bbsmith24/YamuraHubV6.1/README.md

## YamuraLog Hub
Control for YamuraLog sensor network. Start/Stop logging, save log file to microSD, handle FTP communications with data viewer

## Hardware
- Teensy 4.1. Log files go to its built-in microSD slot (4-bit SDIO, `SD.begin(BUILTIN_SDCARD)`), not the display's SD slot.
- Waveshare SN65HVD230 CAN tranciever
- Hosyond 4" 320x480 display (with built in microSD card slot)
- Adafruit Airlift

## Required Libraries
This is a Visual Code/Platform IO project, I don't recommend using Arduino IDE for this, although the code did start there.
Install these libraries:

- `WiFiNINA - Adafruit fork`
- `SPI`
- 'TFT_eSPI'
- 'FlexCan_T4'
- 'ArduinoJson'

## Usage

1. Open `WiFiSecrets.h`.
2. Replace the WiFi credentials:
   - `YOUR_SSID`
   - `YOUR_WIFI_PASSWORD`
3. Replace the FTP server details:
   - `FTP_SERVER`
   - `FTP_USER`
   - `FTP_PASS`
   - 'FTP_PATH'
4. Adjust pin definitions in main.h as needed:
5. Build and upload to Teensy 4.1.
6. For full debug messages, uncomment #define DEBUG_EXTRA_VERBOSE. Use #define DEBUG_VERBOSE for more serious(?) messages
7. Open Serial Monitor at `115200` baud.

## Configuration (SD `config.ini`)

The values in `WiFiSecrets.h` are compiled-in **defaults**. If a `config.ini`
file is present at the top level of the SD card, its fields override those
defaults at boot, and its `[drivers]` section fills the Select Driver menu.
Copy `config.ini.sample` to the card as `config.ini` and edit it. Any field you
omit keeps its compiled default. This keeps real credentials off committed
source. See `Config.h` for the format.

## Notes

- To log anything, you need at least 1 YamuraLog node (GPS, IMU, A/D), appropriate CAN cables and terminators.

## PlatformIO

A `platformio.ini` file is included for Teensy 4.1 builds (`env:teensy41`).
