bbsmith24/YamuraHubV6.1/hardware/YamuraHub_T41/docs/YamuraHub_T41_top.png

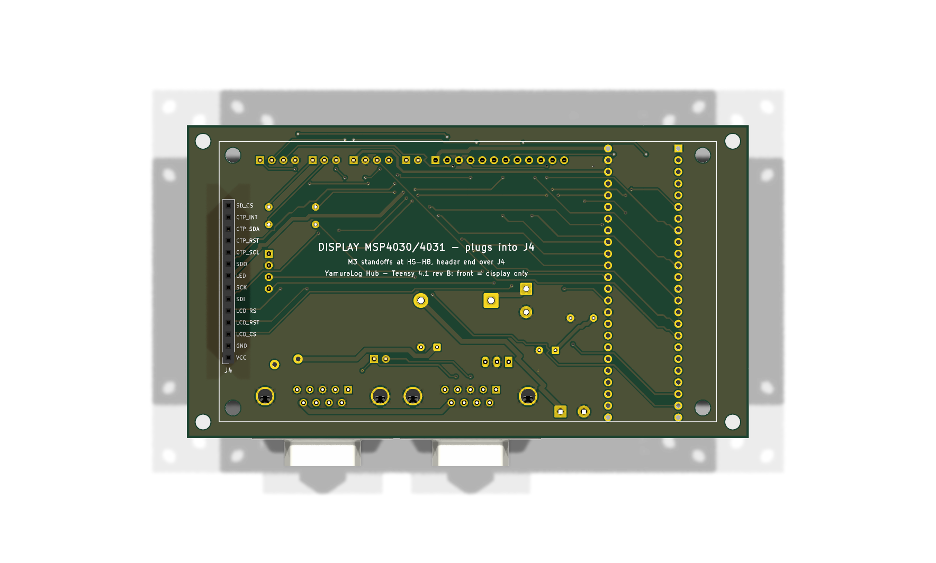
hardware/YamuraHub_T41/docs/YamuraHub_T41_top.png
