bbsmith24/YamuraHubV6.1/hardware/YamuraHub_T41/fab/YamuraHub_T41_BOM.csv

Reference | Value | Footprint | QUANTITY
A1 | Teensy 4.1 | YamuraHub:Teensy41 | 1
A2 | Adafruit AirLift (ESP32) | Connector_PinSocket_2.54mm:PinSocket_1x12_P2.54mm_Vertical | 1
A3 | Waveshare SN65HVD230 CAN board | Connector_PinSocket_2.54mm:PinSocket_1x04_P2.54mm_Vertical | 1
C1 | 47uF 35V | Capacitor_THT:CP_Radial_D8.0mm_P3.50mm | 1
C2 | 47uF 16V | Capacitor_THT:CP_Radial_D8.0mm_P3.50mm | 1
C3 | 100nF | Capacitor_THT:C_Disc_D5.0mm_W2.5mm_P5.00mm | 1
D1 | 1N5822 | Diode_THT:D_DO-201AD_P15.24mm_Horizontal | 1
D4 | 1.5KE20A (TVS) | Diode_THT:D_DO-201AE_P5.08mm_Vertical_CathodeUp | 1
F1 | MF-RG110 (1.1A PTC) | Fuse:Fuse_Bourns_MF-RG1100 | 1
J1 | 12V in | TerminalBlock_Phoenix:TerminalBlock_Phoenix_MKDS-1,5-2-5.08_1x02_P5.08mm_Horizontal | 1
J2 | CAN H/L (from A3) | Connector_PinHeader_2.54mm:PinHeader_1x02_P2.54mm_Vertical | 1
J3 | DB9 male - CAN bus 1 | Connector_Dsub:DSUB-9_Pins_Horizontal_P2.77x2.84mm_EdgePinOffset7.70mm_Housed_MountingHolesOffset9.12mm | 1
J4 | Display socket (MSP4030/4031 14-pin) | Connector_PinSocket_2.54mm:PinSocket_1x14_P2.54mm_Vertical | 1
J5 | I2C (Wire2) / GPS | Connector_PinHeader_2.54mm:PinHeader_1x04_P2.54mm_Vertical | 1
J6 | Panel buttons | Connector_PinHeader_2.54mm:PinHeader_1x04_P2.54mm_Vertical | 1
J7 | Panel LEDs | Connector_PinHeader_2.54mm:PinHeader_1x03_P2.54mm_Vertical | 1
J8 | DB9 male - CAN bus 2 | Connector_Dsub:DSUB-9_Pins_Horizontal_P2.77x2.84mm_EdgePinOffset7.70mm_Housed_MountingHolesOffset9.12mm | 1
JP1 | Display MISO (open) | Connector_PinHeader_2.54mm:PinHeader_1x02_P2.54mm_Vertical | 1
R1,R2 | 330 | Resistor_THT:R_Axial_DIN0207_L6.3mm_D2.5mm_P10.16mm_Horizontal | 2
U1 | R-78E5.0-1.0 | Converter_DCDC:Converter_DCDC_RECOM_R-78E-0.5_THT | 1
