bbsmith24/YamuraHubV6.1/hardware/YamuraHub_T41/docs/layer_bottom.pdf

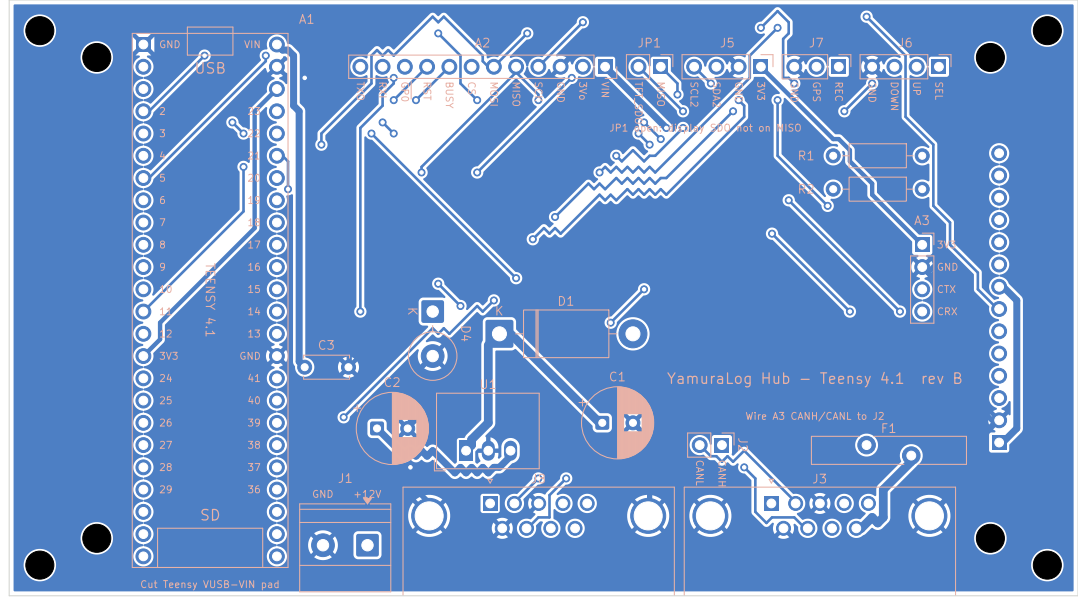
[picture p3: page 1]

CTX CRX Wire A3 CANH/CANL to J2

YamuraLog Hub - Teensy 4.1 rev B
