bbsmith24/YamuraHubV6.1/hardware/YamuraHub_T41/docs/layer_top.pdf

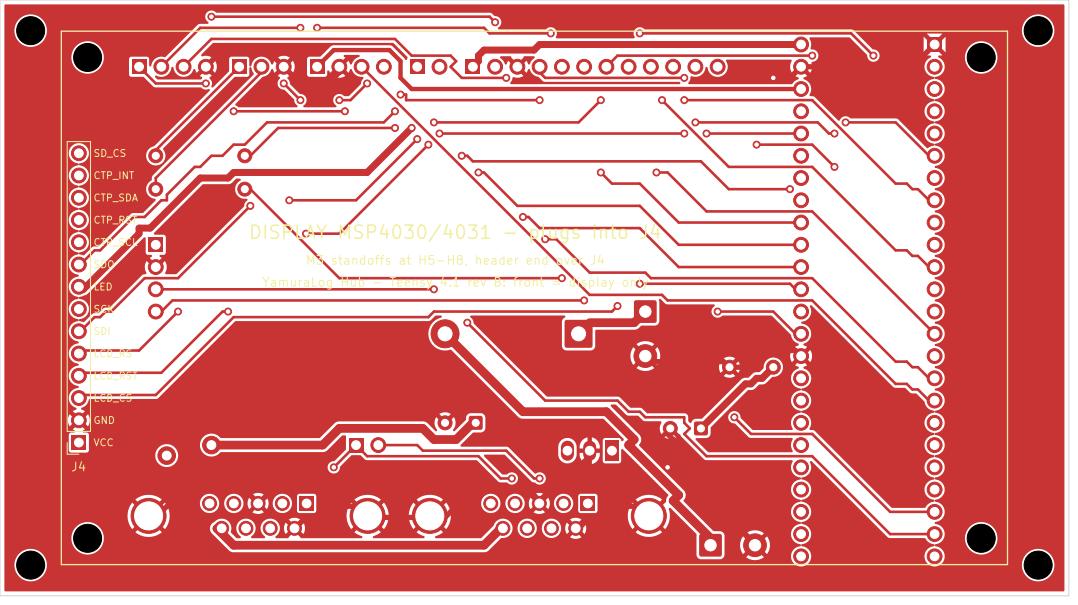
[picture p4: page 1]

YamuraLog Hub - Teensy 4.1 rev B: front = display only DISPLAY MSP4030/4031 - plugs into J4
