bbsmith24/YamuraHubV6.1/hardware/YamuraHub_T41/docs/YamuraHub_T41_schematic.pdf

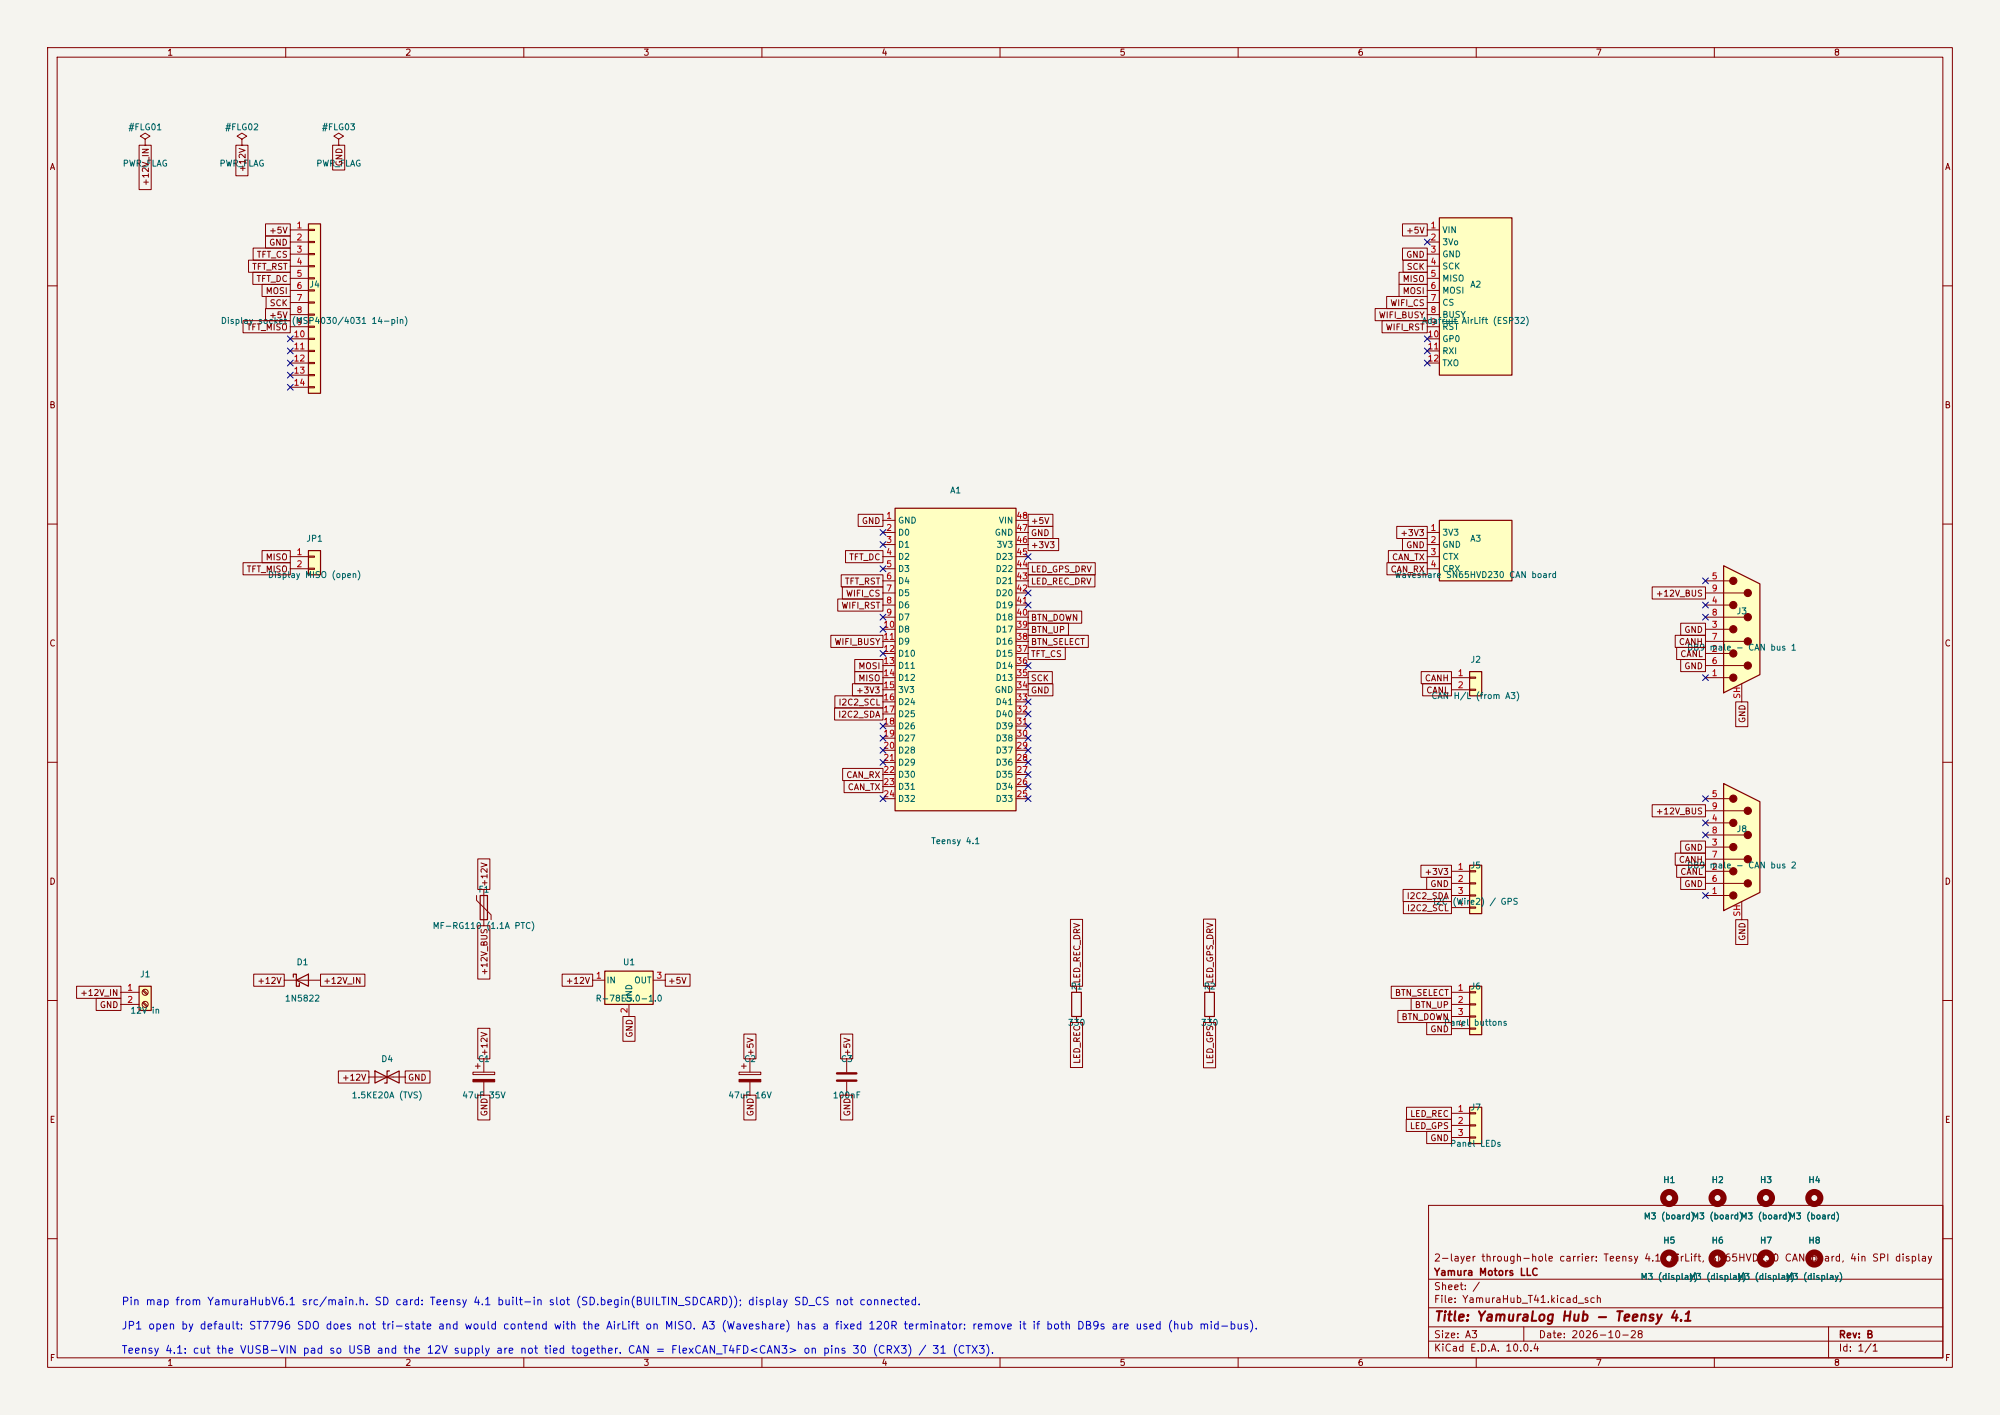
[picture p5: page 1]

VIN 1
GND +5V GND
SCK WIFI_CS MOSI CANL CANH +3V3 GND

Adafruit AirLift (ESP32) WIFI_BUSY MOSI MISO +3V3

2-layer through-hole carrier: Teensy 4.1, AirLift, SN65HVD230 CAN board, 4in SPI display
Yamura Motors LLC
Sheet: /
File: YamuraHub_T41.kicad_sch
Title: YamuraLog Hub - Teensy 4.1

Pin map from YamuraHubV6.1 src/main.h. SD card: Teensy 4.1 built-in slot (SD.begin(BUILTIN_SDCARD)); display SD_CS not connected.

JP1 open by default: ST7796 SDO does not tri-state and would contend with the AirLift on MISO. A3 (Waveshare) has a fixed 120R terminator: remove it if both DB9s are used (hub mid-bus).

Size: A3 | Rev: B
KiCad E.D.A. 10.0.4 | Id: 1/1 | F Date: 2026-10-28
