bbsmith24/YamuraHubV6.1/hardware/YamuraHub_T41/YamuraHub_T41.kicad_pcb

## KiCad design hardware/YamuraHub_T41/YamuraHub_T41.kicad_pcb (2026-10-29)

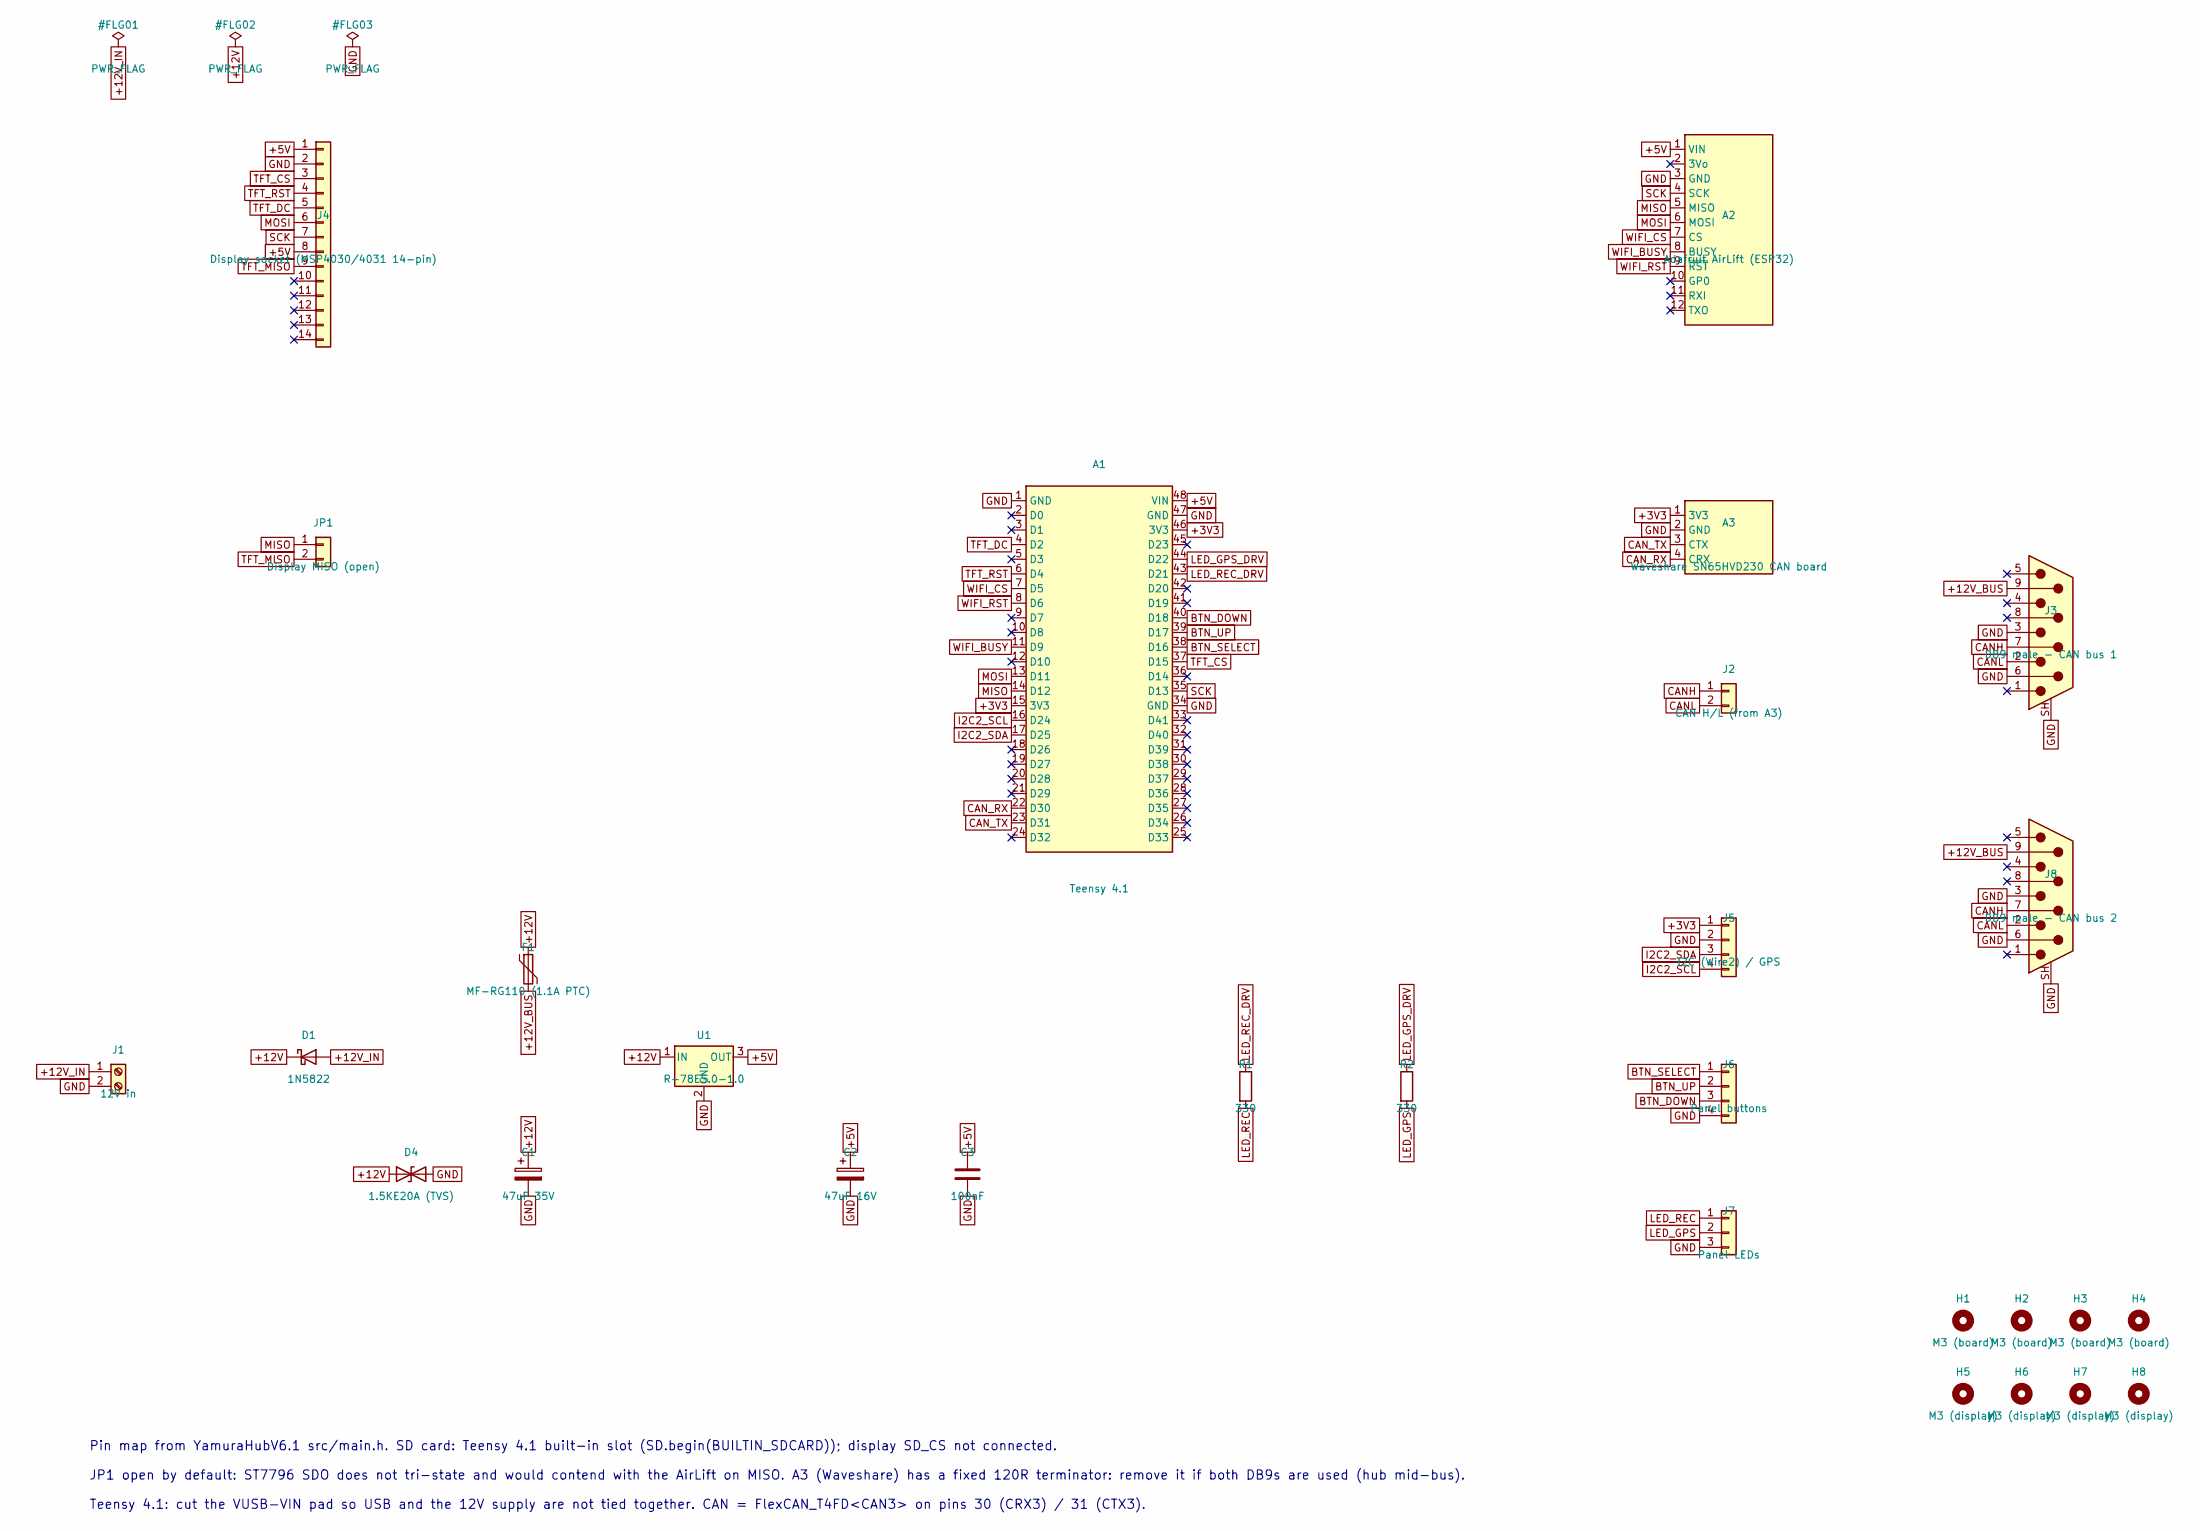
[picture p6: schematic YamuraHub_T41.kicad_sch, YamuraLog Hub - Teensy 4.1]

Parts:
A1: Teensy 4.1; Teensy41
A2: Adafruit AirLift (ESP32); PinSocket_1x12_P2.54mm_Vertical
A3: Waveshare SN65HVD230 CAN board; PinSocket_1x04_P2.54mm_Vertical
C1: 47uF 35V; CP_Radial_D8.0mm_P3.50mm
C2: 47uF 16V; CP_Radial_D8.0mm_P3.50mm
C3: 100nF; C_Disc_D5.0mm_W2.5mm_P5.00mm
D1: 1N5822; D_DO-201AD_P15.24mm_Horizontal
D4: 1.5KE20A (TVS); D_DO-201AE_P5.08mm_Vertical_CathodeUp
F1: MF-RG110 (1.1A PTC); Fuse_Bourns_MF-RG1100
H1, H2, H3, H4: M3 (board); MountingHole_3.2mm_M3
H5, H6, H7, H8: M3 (display); MountingHole_3.2mm_M3
J1: 12V in; TerminalBlock_Phoenix_MKDS-1,5-2-5.08_1x02_P5.08mm_Horizont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
J2: CAN H/L (from A3); PinHeader_1x02_P2.54mm_Vertical
J3: DB9 male - CAN bus 1; DSUB-9_Pins_Horizontal_P2.77x2.84mm_EdgePinOffset7.70mm_Hou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
J4: Display socket (MSP4030/4031 14-pin); PinSocket_1x14_P2.54mm_Vertical
J5: I2C (Wire2) / GPS; PinHeader_1x04_P2.54mm_Vertical
J6: Panel buttons; PinHeader_1x04_P2.54mm_Vertical
J7: Panel LEDs; PinHeader_1x03_P2.54mm_Vertical
J8: DB9 male - CAN bus 2; DSUB-9_Pins_Horizontal_P2.77x2.84mm_EdgePinOffset7.70mm_Hou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
JP1: Display MISO (open); PinHeader_1x02_P2.54mm_Vertical
R1, R2: 330; R_Axial_DIN0207_L6.3mm_D2.5mm_P10.16mm_Horizontal
U1: R-78E5.0-1.0; Converter_DCDC_RECOM_R-78E-0.5_THT

Connections:
+3V3: A1.15 (3V3), A1.46 (3V3), A3.1 (3V3), J5.1
+5V: A1.48 (VIN), A2.1 (VIN), C2.1, C3.1, J4.1, J4.8, U1.3 (OUT)
+12V: C1.1, D1.1 (K), D4.1 (A1), F1.1, U1.1 (IN)
+12V_BUS: F1.2, J3.9, J8.9
+12V_IN: D1.2 (A), J1.1
BTN_DOWN: A1.40 (D18), J6.3
BTN_SELECT: A1.38 (D16), J6.1
BTN_UP: A1.39 (D17), J6.2
CANH: J2.1, J3.7, J8.7
CANL: J2.2, J3.2, J8.2
CAN_RX: A1.22 (D30), A3.4 (CRX)
CAN_TX: A1.23 (D31), A3.3 (CTX)
GND: A1.1 (GND), A1.34 (GND), A1.47 (GND), A2.3 (GND), A3.2 (GND), C1.2, C2.2, C3.2, D4.2 (A2), J1.2, J3.3, J3.6, J3.SH (PAD), J4.2, J5.2, J6.4, J7.3, J8.3, J8.6, J8.SH (PAD), U1.2 (GND)
I2C2_SCL: A1.16 (D24), J5.4
I2C2_SDA: A1.17 (D25), J5.3
LED_GPS: J7.2, R2.2
LED_GPS_DRV: A1.44 (D22), R2.1
LED_REC: J7.1, R1.2
LED_REC_DRV: A1.43 (D21), R1.1
MISO: A1.14 (D12), A2.5 (MISO), JP1.1
MOSI: A1.13 (D11), A2.6 (MOSI), J4.6
SCK: A1.35 (D13), A2.4 (SCK), J4.7
TFT_CS: A1.37 (D15), J4.3
TFT_DC: A1.4 (D2), J4.5
TFT_MISO: J4.9, JP1.2
TFT_RST: A1.6 (D4), J4.4
WIFI_BUSY: A1.11 (D9), A2.8 (BUSY)
WIFI_CS: A1.7 (D5), A2.7 (CS)
WIFI_RST: A1.8 (D6), A2.9 (~RST)

Notes on the sheet:
Pin map from YamuraHubV6.1 src/main.h. SD card: Teensy 4.1 built-in slot (SD.begin(BUILTIN_SDCARD)); display SD_CS not connected.
JP1 open by default: ST7796 SDO does not tri-state and would contend with the AirLift on MISO. A3 (Waveshare) has a fixed 120R terminator: remove it if both DB9s are used (hub mid-bus).
Teensy 4.1: cut the VUSB-VIN pad so USB and the 12V supply are not tied together. CAN = FlexCAN_T4FD<CAN3> on pins 30 (CRX3) / 31 (CTX3).

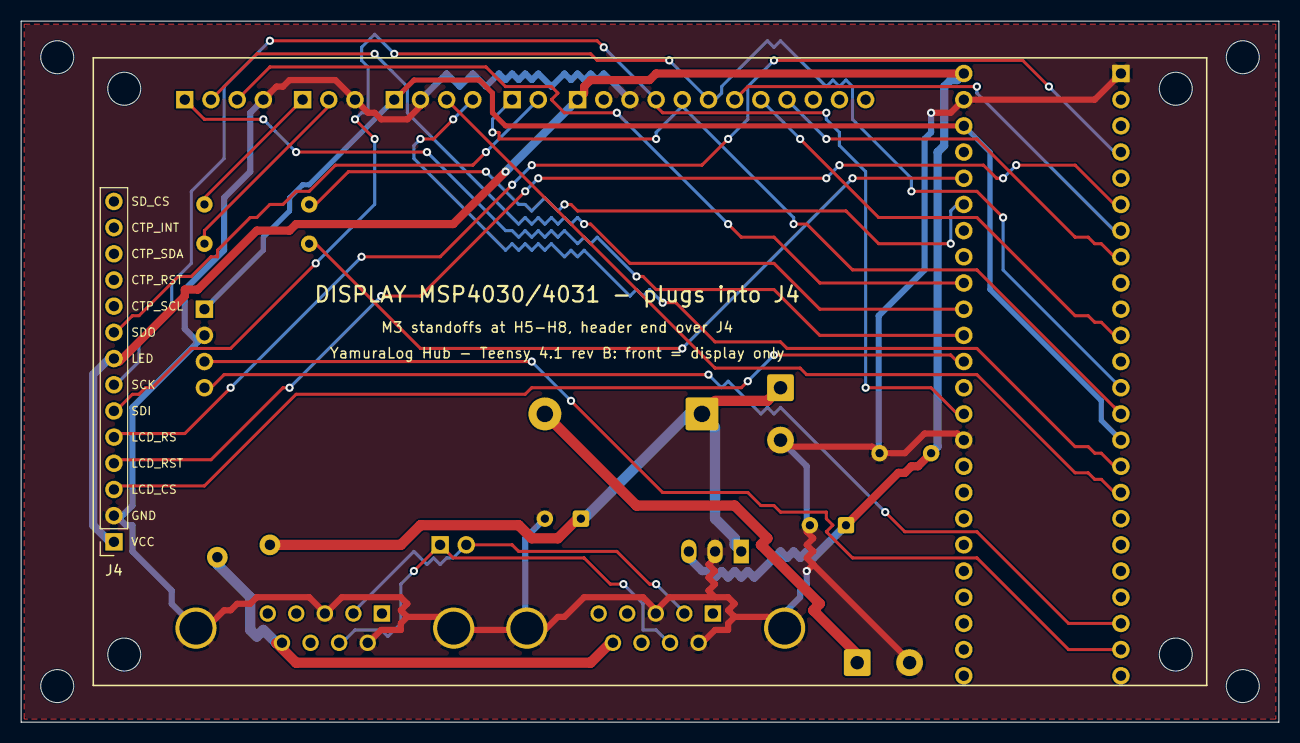
[picture p7: board YamuraHub_T41.kicad_pcb from above]

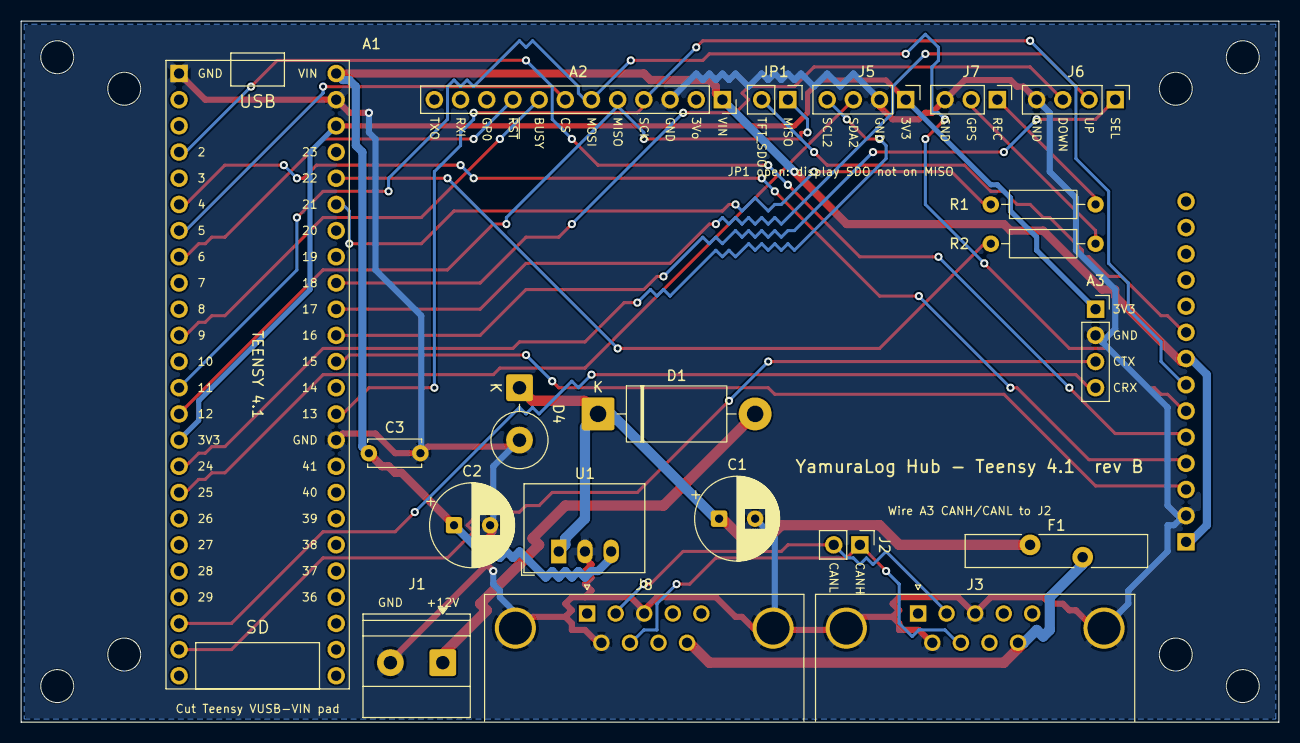
[picture p8: board YamuraHub_T41.kicad_pcb from below]

Board: 2 copper layers, 122.0 x 68.0 mm, 29 parts (20 on the bottom side), 29 nets.
