bbsmith24/YamuraHubV6.1/(commit log)

2026-05-10 Added header
    Added header in main.cpp. Initial checking of locally implemented FTPClient, Teensy 4.0 + Airlift + ESP32 TFT display with built in microSD card. Might be possible to add Airlift functionality to the TFT display....
    Broke TFT menu system out into it's own (at this point partially complete...) class
    [main.cpp]
2026-07-15 file send changes
    added return string from FTP send instead of print to com port, retain last sent on fail (makes it easier to resend)
    [FTPClient.cpp, FTPClient.h, WiFiSecrets.h, main.cpp, main.h]
2026-07-25 user select FTP port, resend on error (5 retrys), ftp error now includes fail to connect to wifi, keep last sent file as default to send #11 #6
    [FTPClient.cpp, FTPClient.h, main.cpp, main.h]
2026-07-27 added LEDs for GPS status (on when SIV > 0) and recording (on when recording). Changed "press any button to continue" to end logging to 10s delay and return to main menu #12 #13 #14
2026-07-29 added break after 5 send fails. Will put on beta logger box next time I flash it.
    [main.cpp]
2026-08-01 Add FTP reliability + speed fixes for pit-stop uploads
    The car leaves WiFi range while running and only reconnects in the pits,
    so every upload re-associates from cold. Harden that path and speed it up.
    Reliability:
    - Poll WiFi.status() with retries instead of trusting WiFi.begin()'s single
    return, which often reports WL_DISCONNECTED/WL_CONNECT_FAILED on a
    slow-but-fine association (main cause of ~50% send failures).
    - Clean up (FTPDisconnect) on every failure path in the SD upload so a
    leaked control socket can't poison the next retry (NINA has few sockets).
    - Accept 125 as well as 150 on STOR/RETR/LIST.
    - flush() after STOR so the reply read doesn't race a buffered send.
    - Remove th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
    [FTPClient.cpp, FTPClient.h]
2026-08-01 Fix truncated uploads; add drain, completeness guard, readable errors
    Follow-up to the reliability/speed commit. Testing showed 200K uploads
    truncating to ~10K: the Adafruit WiFiNINA fork's flush() is a no-op and
    checkDataSent() only confirms the ESP32 buffered a chunk, not that it
    reached the server, so closing the data socket discarded in-flight data
    (FTP STOR has no length, so the server still replied 226 on the short file).
    - Revert to the known-good 256 B / 10 ms pacing (confirmed full 200K
    transfer). FTP_CHUNK_SIZE / FTP_CHUNK_PACING_MS are now tunable for
    stepping speed back up from a working baseline.
    - Drain (FTP_DRAIN_MS) before closing the data socket since flush() does
    not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
    [FTPClient.cpp, FTPClient.h, main.cpp]
2026-08-01 Record FTP speed-tuning result; add transfer throughput log
    Tested on the AirLift over SPI: chunks >256 B fail with a partial send
    (nina-fw per-sendData ceiling) and pacing <10 ms also fails (the module's
    TCP buffer needs ~10 ms to drain each 256 B chunk). 256 B / 10 ms
    (~25 KB/s) is the reliable ceiling; the bottleneck is the module, not the
    code. Kept the known-good values and documented the finding in the header
    so it isn't re-litigated.
    Also log data-phase throughput ("Transfer: N bytes in M ms (R bytes/sec)")
    to make any future tuning measurable.
    [FTPClient.cpp, FTPClient.h]
2026-08-01 Implement Get File: list server files (NLST) and download to SD
    Fills in the GetFileMenu stub so the user can pull a file back from the
    FTP server, mirroring the Send File flow.
    - GetFTPServerFileList(): self-contained connect -> NLST -> disconnect,
    returning bare filenames (easier to parse than LIST). Handles 125/150,
    strips any directory prefix, and treats an empty dir (226/no data) as 0.
    - GetFileFromFTPServer(): self-contained connect -> RETR -> SD -> disconnect,
    buffered 256 B reads, overwrites any existing local copy (SD FILE_WRITE
    appends), verifies 226, logs throughput.
    - GetFileMenu(): stops the heartbeat, fetches the list, builds a selectable
    menu (same calloc/MenuSelect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
2026-08-02 Add SD config.ini (WiFi/FTP + drivers), driver-named logs, debug display
    Introduce a Config module that seeds WiFi/FTP settings from the compiled
    defaults in WiFiSecrets.h (now DEFAULT_* macros) and overrides them per-field
    from a /config.ini on the SD card, which also supplies a driver list.
    - Config.h/.cpp: load /config.ini at boot ([wifi]/[ftp]/[drivers], incl. an
    ftp port key), overriding defaults; small hand-rolled parser, no new deps.
    - Select Driver menu implemented from the loaded driver list.
    - Log files use the selected driver as the filename prefix (replacing
    "sdLog"), sanitized to [A-Za-z0-9_-] and length-capped; GetNextLogFileIdx
    counts per-prefix so numbering continues p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
2026-08-03 Fix NLST parsing for bare-CR line endings (GoFTP/iOS)
    The Get File list only split on LF, so a server that terminates NLST lines
    with bare CR (e.g. GoFTP on iOS) collapsed the whole listing onto one
    unselectable line. FileZilla sends CRLF, which worked. Treat CR, LF, or
    CRLF all as line ends (CR-then-LF finalizes an already-empty line, so no
    blank entries on CRLF servers).
    [FTPClient.cpp]
2026-08-03 Scrub WiFiSecrets defaults to placeholders
    Replace the real WiFi/FTP credentials in the compiled defaults with
    placeholders; real values belong in /config.ini on the SD card. Note: prior
    history still contains the old values, so rotate the actual credentials to
    fully protect them.
    [WiFiSecrets.h]
2026-08-04 Get File: use LIST instead of NLST for cross-server listing
    GoFTP (iOS) returns NLST as one concatenated blob with no delimiter between
    filenames - impossible to split. Switch to LIST (CRLF-delimited ls -l lines)
    and take the filename as the last whitespace field of each line; skip the
    "total" header and strip any path prefix. Confirmed working on FileZilla and
    GoFTP. A raw-byte hex dump is left in temporarily to verify Windows/Android
    servers; it will be removed once those are confirmed.
    [FTPClient.cpp]
2026-08-04 Set system clock from GPS with configurable UTC offset
    GPS time is UTC. Add a [time] utc_offset (hours) to config.ini and apply it
    when the GPS message sets the system clock: local = UTC + offset, via
    makeTime()+setTime(). SD file timestamps written by the DateTimeProvider
    callback are therefore local time. Same config key/format as the hotspot, so
    one config.ini can serve both devices.
2026-08-25 added saved driver, don't ever delete config
    added saved driver, don't ever delete config
2026-08-26 save selected driver
    save selected driver to config.ini file when changed, preserves selection between sessions until user changes it
2026-10-28 Teensy 4.1: log to the built-in microSD slot
    - PlatformIO env/board teensy40 -> teensy41.
    - SD.begin(BUILTIN_SDCARD) (4-bit SDIO) instead of SD.begin(SD_CS) on the
    shared SPI bus; SD_CS (pin 3) removed and the display's SD slot is no
    longer used. Startup pin dump updated to match.
    - README: hardware and build notes for the Teensy 4.1.
    All other pins are unchanged (AirLift 5/6/9, TFT 15/2/4, SPI 11/12/13,
    CAN3 30/31, buttons 16-18, LEDs 21/22).
2026-10-28 Add Teensy 4.1 hub carrier board (KiCad 10, rev A)
    2-layer, all through-hole, 120 x 80 mm carrier for the Teensy 4.1,
    AirLift, Waveshare SN65HVD230 CAN board and the 4" SPI display:
    12V input with reverse-polarity diode, TVS and RECOM R-78E 5V
    regulator; DB9 CAN connector carrying 12V to the nodes through a
    polyfuse; display, I2C (Wire2), panel button and LED headers.
    The schematic, board and fab outputs (Gerbers, drill, BOM) are
    generated from gen/design.py by the scripts in gen/ (schematic,
    netlist-driven placement, grid router, GND pours). ERC clean; DRC with
    schematic parity has 0 unconnected pads and 0 parity errors.
    gen/design.py already holds the in-progress rev B part list (two DB9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
2026-10-29 Hub carrier board rev B: display on front, parts on back, two DB9s
    - 122 x 68 mm board: the 4" display (MSP4030/4031) plugs into J4 on the
    front, long side along the board, on M3 standoffs at its own holes
    (H5-H8); every other part is on the back; M3 holes at the corners.
    - Second DB9 (J8) in parallel with J3 so the CAN bus can pass through
    the hub. Waveshare terminator must come off if both are used.
    - Buttons and LEDs are panel-mounted: SW1-3 and D2/D3 removed, J6/J7
    headers kept (R1/R2 still on board).
    - build_pcb.py flips side "B" parts to the back with mirrored back-side
    silkscreen and draws the display outline on the front.
    - route.py rips up and retries with failed nets firs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
2026-10-29 Add GPS + SD investigation notes
    Analysis of adding GPS to the hub and servicing GPS + CAN FD + SD
    without dropping CAN frames: SPI-SD vs Teensy 4.1 SDIO, file
    preallocation and batched writes, PSRAM buffering trade-offs, and the
    recommended Teensy 4.1 path this branch follows.
2026-11-08 main.h: clarify TFT DC/RST pin comments
2026-11-13 Log IMU accel+gyro messages; show GPS speed in debug output
    The IMU node now sends accel + gyro (28 bytes) on CAN id 0x40. Tell it
    apart from accel-only (16 bytes) by message length and log it as record
    type 0x41, since the log has no length field. Accel-only messages are
    still logged as 0x40. Add ground speed to the GPS debug print.
